RicardoStephen/iCar/Cypress_PSoC/motor_control.cydsn/CortexM0/ARM_GCC_493/Debug/LINK_options.txt

-Wl,--start-group -o ".\\CortexM0\\ARM_GCC_493\\Debug\\motor_control.elf" ".\\CortexM0\\ARM_GCC_493\\Debug\\main.o" ".\\CortexM0\\ARM_GCC_493\\Debug\\control.o" ".\\CortexM0\\ARM_GCC_493\\Debug\\cymetadata.o" ".\\CortexM0\\ARM_GCC_493\\Debug\\Cm0Start.o" ".\\CortexM0\\ARM_GCC_493\\Debug\\motor_control.a" "C:\\Program\ Files\ (x86)\\Cypress\\PSoC\ Creator\\3.3\\PSoC\ Creator\\psoc\\content\\cycomponentlibraryupdates\\CyComponentLibraryUpdates.cylib\\BLE_v2_30\\Library\\gccCyBLEStack_BLE_SOC_PERIPHERAL.a" "C:\\Program\ Files\ (x86)\\Cypress\\PSoC\ Creator\\3.3\\PSoC\ Creator\\psoc\\content\\cycomponentlibrary\\CyComponentLibrary.cylib\\CortexM0\\ARM_GCC_493\\Debug\\CyComponentLibrary.a" -mcpu=cortex-m0 -mthumb -g -ffunction-sections -Og -L "Generated_Source\\PSoC4" "-Wl,-Map,.\\CortexM0\\ARM_GCC_493\\Debug/motor_control.map" -T "Generated_Source\\PSoC4\\cm0gcc.ld" -specs=nano.specs -Wl,--gc-sections -Wl,--end-group
