RicardoStephen/iCar/(commit log)

2016-08-28 moved project to git
    [hbridge_schematic.sch]
2016-08-29 cropped schematics
2016-08-29 mentioned gEDA schematic
